nsinav/xt_ide/XT-IDE.jpg

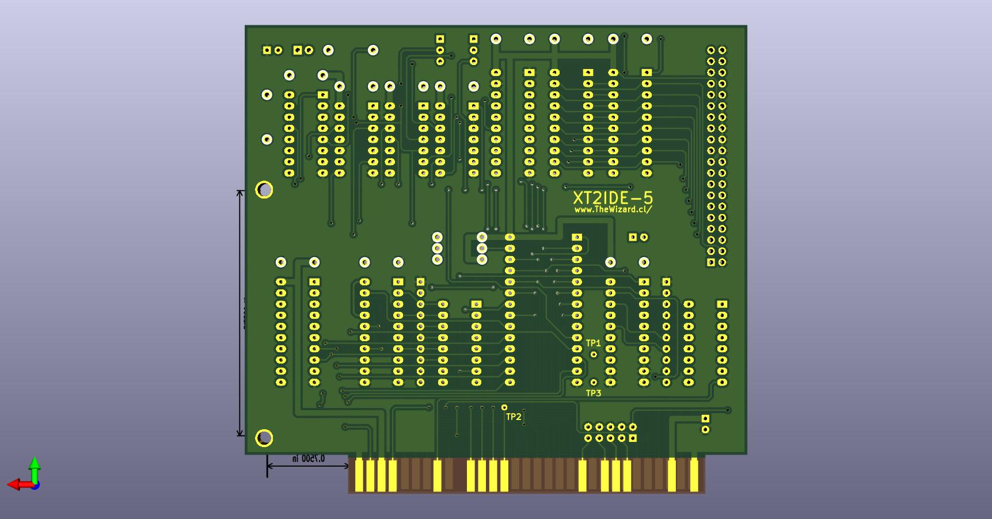
XT-IDE.jpg
