nsinav/xt_ide/(commit log)

2024-04-25 Ignoring KiCAD 8 tempfiles, autosaves
2024-04-25 Ignoring KiCAD 8 backups directory
2024-04-25 WIP KiCAD 8 upgrade, symbol updates, DRC updates
    [XT-IDE.kicad_pcb, XT-IDE.kicad_sch]
2024-04-26 WIP schematic cleanup, net renames, moving to global labels instead of wire labels, fixing polarities
    [XT-IDE.kicad_pcb, XT-IDE.kicad_sch]
2024-04-28 WIP more schematic cleanup
    [XT-IDE.kicad_sch]
2024-11-11 Updating gitignore for KiCAD 8
2024-11-11 Removing legacy files
    [XT-IDE.sch]
2024-11-11 PROTOTYPE 2 run for KiCAD 8 upgrade
    [XT-IDE-B.Mask.gbs, XT-IDE-B_Mask.gbs, XT-IDE-Copper.gbl, XT-IDE-Eco1.User.gbr, XT-IDE-Edge.Cuts.gm1, XT-IDE-Edge_Cuts.gm1, XT-IDE-F.Mask.gts, XT-IDE-F.SilkS.gto]
