nsinav/xt_ide/(notices)

Notices in the files:
XT-IDE.kicad_pcb:
XT-IDE rev 05 (c) 2025 The Wizard
